davidcamilo0710/SpeedyLineFollowing_Robot/README.md

# Speedy Line Following Robot

This project was carried out for a competition at the University of Cauca. It consists of a line follower robot that seeks to travel a circuit at maximum speed, a PID control was used and it was implemented in an Arduino nano. All the instructions are in the manual.

msedge_ReLyEONkno-PhotoRoom-PhotoRoom
